MakerPlayground/MakerPlayground_BaseBoard/README.md

# MakerPlayground_BaseBoard
Maker Playground Base Board schematic and PCB design.

Complete the design with Kicad 5.0.2 or newer.
