MakerPlayground/MakerPlayground_BaseBoard/MP_AvrBaseBoard_v4/MakerPlayground_Baseboard.kicad_pcb

## KiCad design MP_AvrBaseBoard_v4/MakerPlayground_Baseboard.kicad_pcb (2021-03-02)

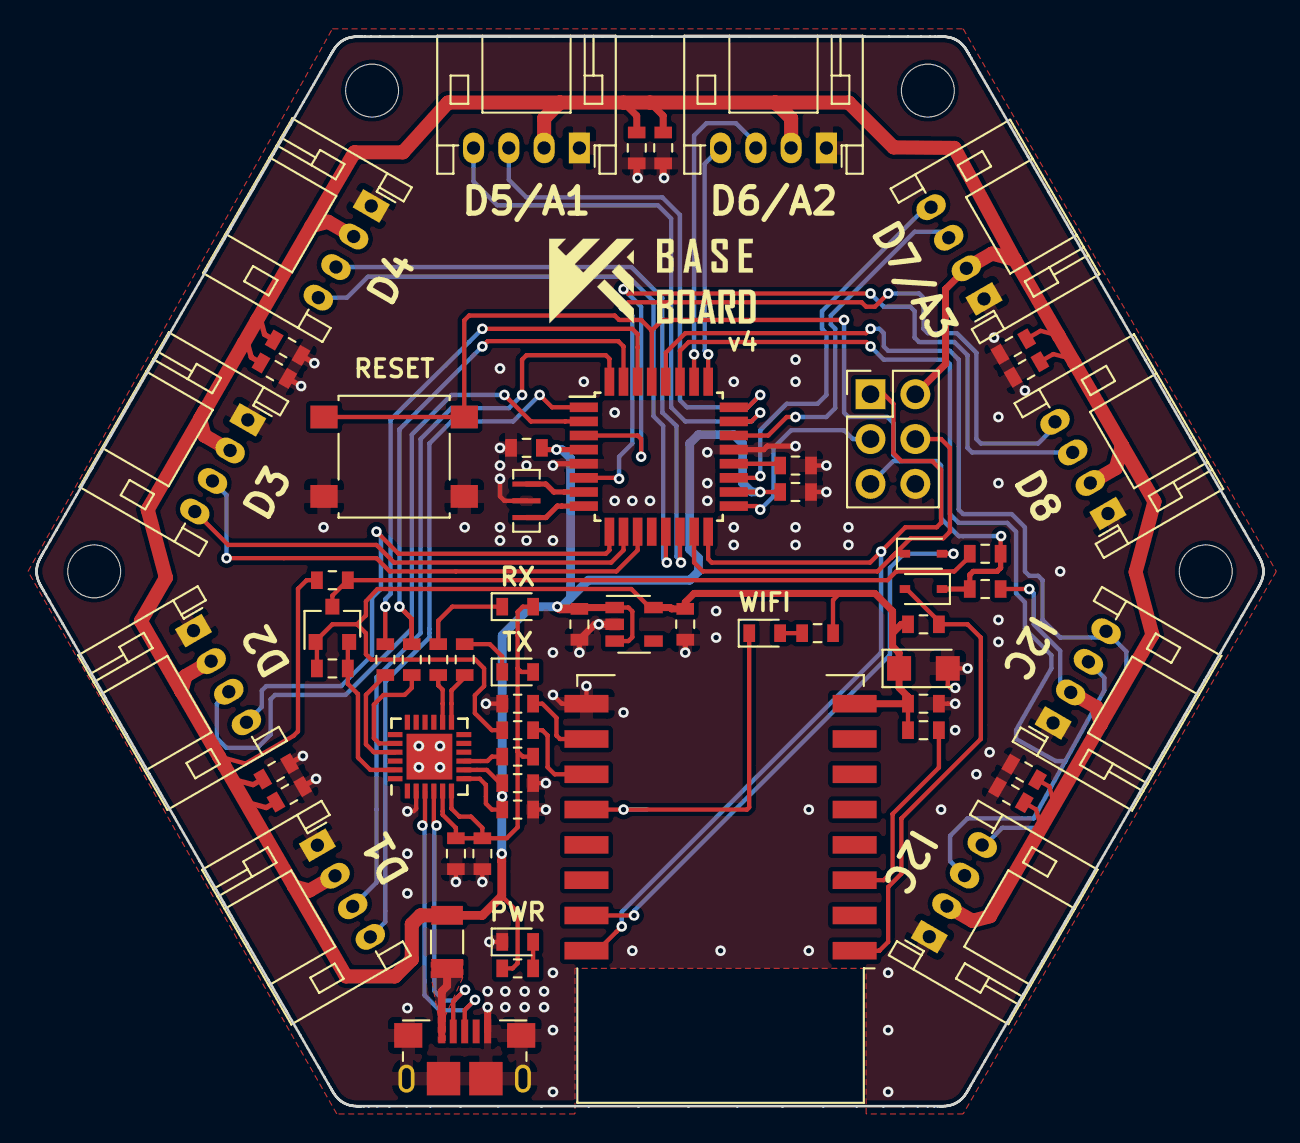
[picture p1: board MakerPlayground_Baseboard.kicad_pcb from above]

Board: 2 copper layers, 69.5 x 60.6 mm, 63 parts (1 on the bottom side), 51 nets.

Parts:
C1, C2: 4.7uF; C_0603_1608Metric
C3, C5, C7, C11, C12, C13, C15, C16, C18, C20, C22: 0.1uF; C_0603_1608Metric
C4, C9, C17, C19, C21: 10uF; C_0603_1608Metric
C6, C8, C14: 1uF; C_0603_1608Metric
C10: 10uF; CP_EIA-3216-12_Kemet-S
D2: Green; LED_0603_1608Metric
D3, D4: Yellow; LED_0603_1608Metric
D5, D7: 1SS355VMTE-17; D_SOD-323
D6: RED; LED_0603_1608Metric
F1: 6V/0.5A; Fuse_1206_3216Metric
J2: USB_B_Micro; USB_Micro-B_Amphenol_10118193_Horizontal
J3: AVR-ISP-6; PinHeader_2x03_P2.54mm_Vertical
J4, J5, J6, J7, J8, J9, J10, J11, J13, J14: 112504RT/RH; JST_PH_S4B-PH-K_1x04_P2.00mm_Horizontal
JP1: Flashing Mode; SolderJumper-2_P1.3mm_Open_Pad1.0x1.5mm
Q2: BSS138; SOT-23
R2, R5, R6, R7, R8, R9, R14: 1K; R_0603_1608Metric
R3, R4, R10, R11, R12, R13, R15: 10K; R_0603_1608Metric
SW1: RESET; SW_SPST_B3S-1000
U2: AP2127K-3.3; SOT-23-5
U3: CP2102N-A01-GQFN24; QFN-24-1EP_4x4mm_P0.5mm_EP2.6x2.6mm
U4: ATmega328PB-MU; TQFP-32_7x7mm_P0.8mm
U5: ESP-12E; ESP-12E_ButtLess
Y1: CSTCE16M0V53-R0; Resonator_Murata_CSTCE-V-3Pin_3.2x1.3mm

Connections:
+3V3: C8.1, C10.1, C14.1, Q2.1, R3.1, R10.2, R11.1, R13.1, R14.1, U2.5, U5.8
+5V: C2.1, C4.1, C5.1, C6.1, C7.1, C9.1, C11.1, C13.1, C16.1, C17.1, C18.1, C19.1, C20.1, C21.1, C22.1, F1.1, J3.2, J4.2, J5.2, J6.2, J7.2, J8.2, J9.2, J10.2, J11.2, J13.2, J14.2, R4.1, R5.1, R15.1, U2.1, U2.3, U3.7, U3.8, U4.4, U4.18
/D+: J2.3, U3.3
/D-: J2.2, U3.4
A0: J5.4, U4.23
A1: J5.3, U4.24
A2: J8.4, U4.25
A3: J8.3, U4.26
A4: J11.4, U4.19
A5: J11.3, U4.22
D2: J4.3, U4.32
D3: J4.4, U4.1
D4: J7.3, U4.2
D5: J7.4, U4.9
D6: J10.4, U4.10
D7: J10.3, U4.11
D9: J13.4, U4.13
D10: J13.3, U4.14
D11: J14.3, U4.3
D12: J14.4, U4.6
DTR: C15.1, Q2.3, R4.2
DTR_3V3: Q2.2, R3.2, U3.23
ESP_RX: D7.1, J3.4, U4.15
ESP_TX: J3.1, U4.16, U5.22
GND: C1.2, C2.2, C3.2, C4.2, C5.2, C6.2, C7.2, C8.2, C9.2, C10.2, C11.2, C12.2, C13.2, C14.2, C16.2, C17.2, C18.2, C19.2, C20.2, C21.2, C22.2, D2.1, J2.5, J2.6, J3.6, J4.1, J5.1, J6.1, J7.1, J8.1, J9.1, J10.1, J11.1, J13.1, J14.1, JP1.2, R12.1, SW1.2, U2.2, U3.2, U3.25, U4.5, U4.21, U5.15, Y1.2
MCU_RX: R7.1, U4.30
MCU_TX: R6.1, U4.31
unnamed: C1.1, C3.1, D3.2, D4.2, R2.1, U3.5, U3.6
unnamed: C12.1, U4.20
unnamed: D2.2, R5.2
unnamed: D3.1, R8.1
unnamed: D4.1, R9.1
unnamed: D5.2, R11.2, U5.1
unnamed: D6.1, JP1.1, U5.18
unnamed: D6.2, R14.2
unnamed: D7.2, U5.21
unnamed: F1.2, J2.1
unnamed: R2.2, U3.9
unnamed: R6.2, U3.20
unnamed: R7.2, U3.21
unnamed: R8.2, U3.13
unnamed: R9.2, U3.14
unnamed: R10.1, U5.3
unnamed: R12.2, U5.16
unnamed: R13.2, U5.17
unnamed: U4.7, Y1.3
unnamed: U4.8, Y1.1
RST: C15.2, D5.1, J3.5, R15.2, SW1.1, U4.29
SCK: J3.3, U4.17
SCL0: J6.4, J9.4, U4.28
SDA0: J6.3, J9.3, U4.27
