MakerPlayground/MakerPlayground_BaseBoard/MP_SamBaseBoard_V1/MP_SamBaseBoard_V1.kicad_pcb

## KiCad design MP_SamBaseBoard_V1/MP_SamBaseBoard_V1.kicad_pcb (2020-07-10)

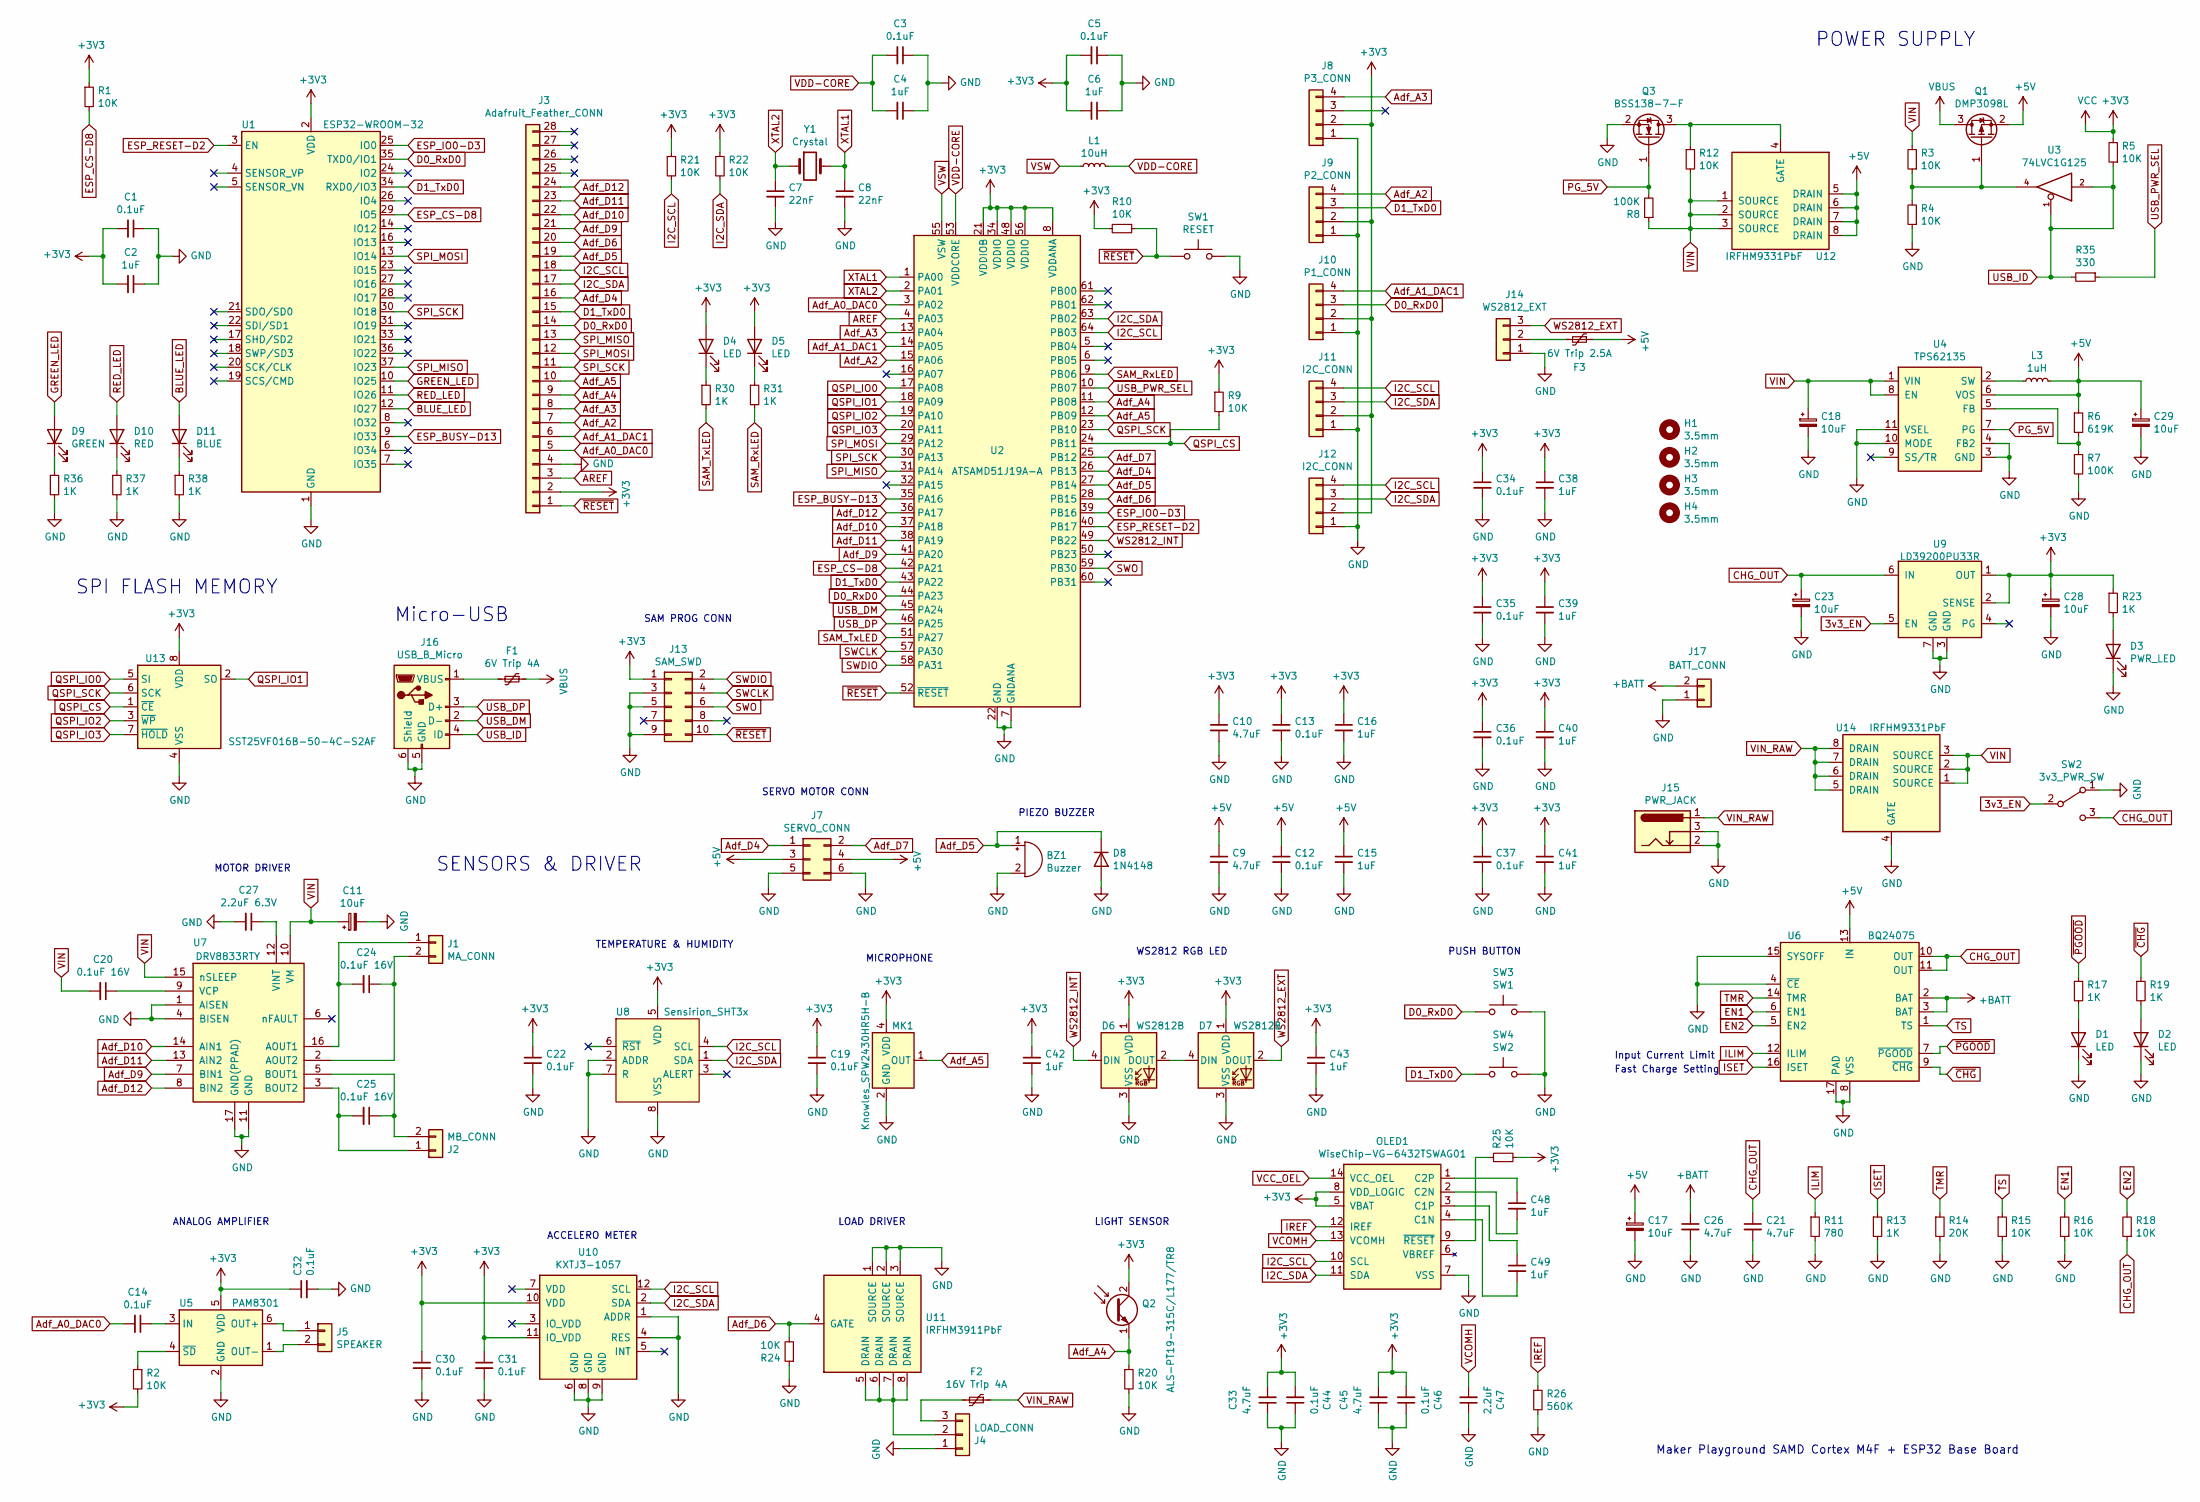
[picture p2: schematic MP_SamBaseBoard_V1.sch]

Parts:
BZ1: Buzzer; MagneticBuzzer_Kobitone_254-EMB84Q-RO
C1, C3, C5, C12, C13, C14, C19, C22, C30, C31, C32, C34, C35, C36, C37, C44, C46: 0.1uF; C_0603_1608Metric
C2, C4, C6, C15, C16, C38, C39, C40, C41, C42, C43, C48, C49: 1uF; C_0603_1608Metric
C7, C8: 22nF; C_0603_1608Metric; Mfg. Part 06036C223KAT2A
C9, C10, C21, C26, C33, C45: 4.7uF; C_0603_1608Metric
C11, C17, C18, C23, C28, C29: 10uF; CP_EIA-3216-12_Kemet-S
C20, C24, C25: 0.1uF 16V; C_0603_1608Metric
C27: 2.2uF 6.3V; C_0603_1608Metric
C47: 2.2uF; C_0603_1608Metric
D1, D2, D4, D5: LED; LED_0603_1608Metric
D3: PWR_LED; LED_0603_1608Metric
D6, D7: WS2812B; WS2812B_MINI
D8: 1N4148; D_SOD-323
D9: GREEN; LED_0603_1608Metric
D10: RED; LED_0603_1608Metric
D11: BLUE; LED_0603_1608Metric
F1: 6V Trip 4A; Fuse_1206_3216Metric; Mfg Part TLC-NSMD200
F2: 16V Trip 4A; Fuse_1812_4532Metric; Mfg Part SMD1812P200TF16
F3: 6V Trip 2.5A; Fuse_1812_4532Metric; Mfg Part MF-MSMF125-2
H1, H2, H3, H4: 3.5mm; MountingHole_3.5mm
J1: MA_CONN; TerminalBlock_Dinkle_ED350V_1x02_P3.50mm_Horizontal
J2: MB_CONN; TerminalBlock_Dinkle_ED350V_1x02_P3.50mm_Horizontal
J3: Adafruit_Feather_CONN; Adafruit-Feather_WoMountPoint_TypeB
J4: LOAD_CONN; TerminalBlock_Dinkle_ED350V_1x03_P3.50mm_Horizontal
J5: SPEAKER; TerminalBlock_Dinkle_ED350V_1x02_P3.50mm_Horizontal
J7: SERVO_CONN; PinHeader_2x03_P2.54mm_Vertical
J8: P3_CONN; JST_PH_B4B-PH-K_1x04_P2.00mm_Vertical
J9: P2_CONN; JST_PH_B4B-PH-K_1x04_P2.00mm_Vertical
J10: P1_CONN; JST_PH_B4B-PH-K_1x04_P2.00mm_Vertical
J11, J12: I2C_CONN; JST_PH_B4B-PH-K_1x04_P2.00mm_Vertical
J13: SAM_SWD; PinHeader_2x05_P1.27mm_Vertical
J14: WS2812_EXT; PinHeader_1x03_P2.54mm_Vertical
J15: PWR_JACK; BarrelJack_Horizontal; Mfg. Part PJ-002A; Mouser No. 490-PJ-002A
J16: USB_B_Micro; USB_Micro-B_Amphenol_10118193_Horizontal
J17: BATT_CONN; TerminalBlock_Dinkle_ED350V_1x02_P3.50mm_Horizontal
L1: 10uH; L_0805_2012Metric; Mfg. Part LQM21DH100M70L
L3: 1uH; SPM6530T; Mfg. Part SPM6530T-1R0M120
MK1: Knowles_SPW2430HR5H-B; SPW2430HR5H-B
OLED1: WiseChip-VG-6432TSWAG01
Q1: DMP3098L; SOT-23
Q2: ALS-PT19-315C/L177/TR8; D_0603_1608Metric
Q3: BSS138-7-F; SOT-23
R1, R2, R3, R4, R5, R9, R10, R12, R15, R16, R18, R20, R21, R22, R24, R25: 10K; R_0603_1608Metric
R6: 619K; R_0603_1608Metric
R7, R8: 100K; R_0603_1608Metric
R11: 780; R_0603_1608Metric
R13, R17, R19, R23, R30, R31, R36, R37, R38: 1K; R_0603_1608Metric
R14: 20K; R_0603_1608Metric
R26: 560K; R_0603_1608Metric
R35: 330; R_0603_1608Metric
SW1: RESET; SW_Push_TS-1145A-B-A
SW2: 3v3_PWR_SW; SSSS811101
SW3: SW1; SW_Push_TS-1145A-B-A
SW4: SW2; SW_Push_TS-1145A-B-A
U1: ESP32-WROOM-32; ESP32-WROOM-32_WifiNinaPin
U2: ATSAMD51J19A-A; TQFP-64_10x10mm_P0.5mm
U3: 74LVC1G125; SOT-23-5
U4: TPS62135; VQFN-HR-11
U5: PAM8301; SOT-23-6
U6: BQ24075; VQFN-16-1EP_3x3mm_P0.5mm_EP1.6x1.6mm_ThermalVias
U7: DRV8833RTY; Texas_S-PWQFN-N16_EP2.1x2.1mm_ThermalVias
U8: Sensirion_SHT3x
U9: LD39200PU33R; DFN-6-1EP_3x3mm_P0.95mm_EP1.7x2.6mm
U10: KXTJ3-1057; LGA-12_2x2mm_P0.5mm
U11: IRFHM3911PbF; PQFN_3x3mm_IRFHM3911PbF
U12, U14: IRFHM9331PbF; PQFN_3x3mm_IRFHM9331TRPbF
U13: SST25VF016B-50-4C-S2AF; SOIC-8_5.275x5.275mm_P1.27mm
Y1: Crystal; Crystal_SMD_2012-2Pin_2.0x1.2mm; Mfg. Part ABS06-127-32.768kHz-T

Connections:
3v3_EN: SW2.2 (B), U9.5 (EN)
+3V3: C1.2, C2.2, C5.2, C6.2, C10.1, C13.1, C16.1, C19.1, C22.1, C28.1, C30.1, C31.1, C32.1, C33.2, C34.1, C35.1, C36.1, C37.1, C38.1, C39.1, C40.1, C41.1, C42.1, C43.1, C44.2, C45.2, C46.2, D4.2 (A), D5.2 (A), D6.1 (VDD), D7.1 (VDD), J3.2, J8.2, J9.2, J10.2, J11.2, J12.2, J13.1, MK1.4 (VDD), OLED1.5 (VBAT), OLED1.8 (VDD_LOGIC), Q2.2 (C), R1.1, R2.2, R5.2, R9.1, R10.2, R21.1, R22.1, R23.1, R25.2, U1.2 (VDD), U2.8 (VDDANA), U2.21 (VDDIOB), U2.34 (VDDIO), U2.48 (VDDIO), U2.56 (VDDIO), U3.5 (VCC), U5.5 (VDD), U8.5 (VDD), U9.1 (OUT), U9.2 (SENSE), U10.10 (VDD), U10.11 (IO_VDD), U13.8 (VDD)
+5V: C9.1, C12.1, C15.1, C17.1, C29.1, F3.1, J7.3, J7.4, L3.2, Q1.2 (S), R6.1, U4.6 (VOS), U6.13 (IN), U12.5 (DRAIN), U12.6 (DRAIN), U12.7 (DRAIN), U12.8 (DRAIN)
+BATT: C26.1, J17.2, U6.2 (BAT), U6.3 (BAT)
AREF: J3.3, U2.4 (PA03)
Adf_A0_DAC0: C14.2, J3.5, U2.3 (PA02)
Adf_A1_DAC1: J3.6, J10.4, U2.14 (PA05)
Adf_A2: J3.7, J9.4, U2.15 (PA06)
Adf_A3: J3.8, J8.4, U2.13 (PA04)
Adf_A4: J3.9, Q2.1 (E), R20.1, U2.11 (PB08)
Adf_A5: J3.10, MK1.1 (OUT), U2.12 (PB09)
Adf_D4: J3.16, J7.1, U2.26 (PB13)
Adf_D5: BZ1.1 (-), D8.1 (K), J3.19, U2.27 (PB14)
Adf_D6: J3.20, R24.2, U2.28 (PB15), U11.4 (GATE)
Adf_D7: J7.2, U2.25 (PB12)
Adf_D9: J3.21, U2.41 (PA20), U7.7 (BIN1)
Adf_D10: J3.22, U2.37 (PA18), U7.14 (AIN1)
Adf_D11: J3.23, U2.38 (PA19), U7.13 (AIN2)
Adf_D12: J3.24, U2.36 (PA17), U7.8 (BIN2)
BLUE_LED: D11.2 (A), U1.12 (IO27)
CHG_OUT: C21.1, C23.1, R18.1, SW2.3 (C), U6.10 (OUT), U6.11 (OUT), U9.6 (IN)
D0_RxD0: J3.14, J10.3, SW3.1, U1.35 (TXD0/IO1), U2.44 (PA23)
D1_TxD0: J3.15, J9.3, SW4.1, U1.34 (RXD0/IO3), U2.43 (PA22)
EN1: R16.2, U6.6 (EN1)
EN2: R18.2, U6.5 (EN2)
ESP_BUSY-D13: U1.9 (IO33), U2.35 (PA16)
ESP_CS-D8: R1.2, U1.29 (IO5), U2.42 (PA21)
ESP_IO0-D3: U1.25 (IO0), U2.39 (PB16)
ESP_RESET-D2: U1.3 (EN), U2.40 (PB17)
GND: BZ1.2 (+), C1.1, C2.1, C3.1, C4.1, C5.1, C6.1, C7.2, C8.2, C9.2, C10.2, C11.2, C12.2, C13.2, C15.2, C16.2, C17.2, C18.2, C19.2, C21.2, C22.2, C23.2, C26.2, C27.2, C28.2, C29.2, C30.2, C31.2, C32.2, C33.1, C34.2, C35.2, C36.2, C37.2, C38.2, C39.2, C40.2, C41.2, C42.2, C43.2, C44.1, C45.1, C46.1, C47.1, D1.1 (K), D2.1 (K), D3.1 (K), D6.3 (VSS), D7.3 (VSS), D8.2 (A), J3.4, J4.1, J7.5, J7.6, J8.1, J9.1, J10.1, J11.1, J12.1, J13.3, J13.5, J13.9, J14.1, J15.2, J15.3, J16.5 (GND), J16.6 (Shield), J17.1, MK1.2 (GND), MK1.3 (GND), OLED1.7 (VSS), Q3.2 (S), R4.1, R7.2, R11.2, R13.2, R14.2, R15.2, R16.1, R20.2, R24.1, R26.2, R36.2, R37.2, R38.2, SW1.2, SW2.1 (A), SW3.2, SW4.2, U1.1 (GND), U1.15 (GND), U1.38 (GND), U1.39 (GND), U2.7 (GNDANA), U2.22 (GND), U2.33 (GND), U2.47 (GND), U2.54 (GND), U3.3 (GND), U4.3 (GND), U4.4 (FB2), U4.10 (MODE), U4.11 (VSEL), U5.2 (GND), U6.4 (~CE), U6.8 (VSS), U6.15 (SYSOFF), U6.17 (PAD), U7.1 (AISEN), U7.4 (BISEN), U7.11 (GND), U7.17 (GND(PPAD)), U8.2 (ADDR), U8.7 (R), U8.8 (VSS), U8.9 (PAD), U9.3 (GND), U9.7 (GND), U10.1 (ADDR), U10.4 (RES), U10.6 (GND), U10.8 (GND), U10.9 (GND), U11.1 (SOURCE), U11.2 (SOURCE), U11.3 (SOURCE), U13.4 (VSS), U14.4 (GATE)
GREEN_LED: D9.2 (A), U1.10 (IO25)
I2C_SCL: J3.18, J11.4, J12.4, OLED1.10 (SCL), R21.2, U2.64 (PB03), U8.4 (SCL), U10.12 (SCL)
I2C_SDA: J3.17, J11.3, J12.3, OLED1.11 (SDA), R22.2, U2.63 (PB02), U8.1 (SDA), U10.2 (SDA)
ILIM: R11.1, U6.12 (ILIM)
IREF: OLED1.12 (IREF), R26.1
ISET: R13.1, U6.16 (ISET)
unnamed: C14.1, U5.3 (IN)
unnamed: C20.1, U7.9 (VCP)
unnamed: C24.1, J1.2, U7.2 (AOUT2)
unnamed: C24.2, J1.1, U7.16 (AOUT1)
unnamed: C25.1, J2.2, U7.5 (BOUT1)
unnamed: C25.2, J2.1, U7.3 (BOUT2)
unnamed: C27.1, U7.12 (VINT)
unnamed: C48.1, OLED1.1 (C2P)
unnamed: C48.2, OLED1.2 (C2N)
unnamed: C49.1, OLED1.3 (C1P)
unnamed: C49.2, OLED1.4 (C1N)
unnamed: D1.2 (A), R17.2
unnamed: D2.2 (A), R19.2
unnamed: D3.2 (A), R23.2
unnamed: D4.1 (K), R30.1
unnamed: D5.1 (K), R31.1
unnamed: D6.2 (DOUT), D7.4 (DIN)
unnamed: D9.1 (K), R36.1
unnamed: D10.1 (K), R37.1
unnamed: D11.1 (K), R38.1
unnamed: F1.2, J16.1 (VBUS)
unnamed: F2.2, J4.3
unnamed: F3.2, J14.2
unnamed: J4.2, U11.5 (DRAIN), U11.6 (DRAIN), U11.7 (DRAIN), U11.8 (DRAIN)
unnamed: J5.1, U5.6 (OUT+)
unnamed: J5.2, U5.1 (OUT-)
unnamed: L3.1, U4.2 (SW)
unnamed: OLED1.9 (~RESET), R25.1
unnamed: Q1.1 (G), R3.1, R4.2, U3.4
unnamed: Q3.3 (D), R12.1, U12.4 (GATE)
unnamed: R2.1, U5.4 (~SD)
unnamed: R6.2, R7.1, U4.5 (FB)
PG_5V: Q3.1 (G), R8.2, U4.7 (PG)
QSPI_CS: R9.2, U2.24 (PB11), U13.1 (~CE)
QSPI_IO0: U2.17 (PA08), U13.5 (SI)
QSPI_IO1: U2.18 (PA09), U13.2 (SO)
QSPI_IO2: U2.19 (PA10), U13.3 (~WP~)
QSPI_IO3: U2.20 (PA11), U13.7 (~HOLD~)
QSPI_SCK: U2.23 (PB10), U13.6 (SCK)
RED_LED: D10.2 (A), U1.11 (IO26)
SAM_RxLED: R31.2, U2.9 (PB06)
SAM_TxLED: R30.2, U2.51 (PA27)
SPI_MISO: J3.13, U1.37 (IO23), U2.31 (PA14)
SPI_MOSI: J3.12, U1.13 (IO14), U2.29 (PA12)
SPI_SCK: J3.11, U1.30 (IO18), U2.30 (PA13)
SWCLK: J13.4, U2.57 (PA30)
SWDIO: J13.2, U2.58 (PA31)
SWO: J13.6, U2.59 (PB30)
TMR: R14.1, U6.14 (TMR)
TS: R15.1, U6.1 (TS)
USB_DM: J16.2 (D-), U2.45 (PA24)
USB_DP: J16.3 (D+), U2.46 (PA25)
USB_ID: J16.4 (ID), R5.1, R35.2, U3.1, U3.2
USB_PWR_SEL: R35.1, U2.10 (PB07)
VBUS: F1.1, Q1.3 (D)
VCOMH: C47.2, OLED1.13 (VCOMH)
VDD-CORE: C3.2, C4.2, L1.2, U2.53 (VDDCORE)
VIN: C11.1, C18.1, C20.2, R3.2, R8.1, R12.2, U4.1 (VIN), U4.8 (EN), U7.10 (VM), U7.15 (nSLEEP), U12.1 (SOURCE), U12.2 (SOURCE), U12.3 (SOURCE), U14.1 (SOURCE), U14.2 (SOURCE), U14.3 (SOURCE)
VIN_RAW: F2.1, J15.1, U14.5 (DRAIN), U14.6 (DRAIN), U14.7 (DRAIN), U14.8 (DRAIN)
VSW: L1.1, U2.55 (VSW)
WS2812_EXT: D7.2 (DOUT), J14.3
WS2812_INT: D6.4 (DIN), U2.49 (PB22)
XTAL1: C8.1, U2.1 (PA00), Y1.2
XTAL2: C7.1, U2.2 (PA01), Y1.1
~CHG: R19.1, U6.9 (~CHG)
~PGOOD: R17.1, U6.7 (~PGOOD)
~RESET: J3.1, J13.10, R10.1, SW1.1, U2.52 (~RESET)

Notes on the sheet:
POWER SUPPLY
SENSORS & DRIVER
ACCELERO METER
TEMPERATURE & HUMIDITY
MOTOR DRIVER
ANALOG AMPLIFIER
LOAD DRIVER
MICROPHONE
Maker Playground SAMD Cortex M4F + ESP32 Base Board
PIEZO BUZZER
SPI FLASH MEMORY
Fast Charge Setting
Input Current Limit
Micro-USB
SERVO MOTOR CONN
SAM PROG CONN
WS2812 RGB LED
LIGHT SENSOR
PUSH BUTTON

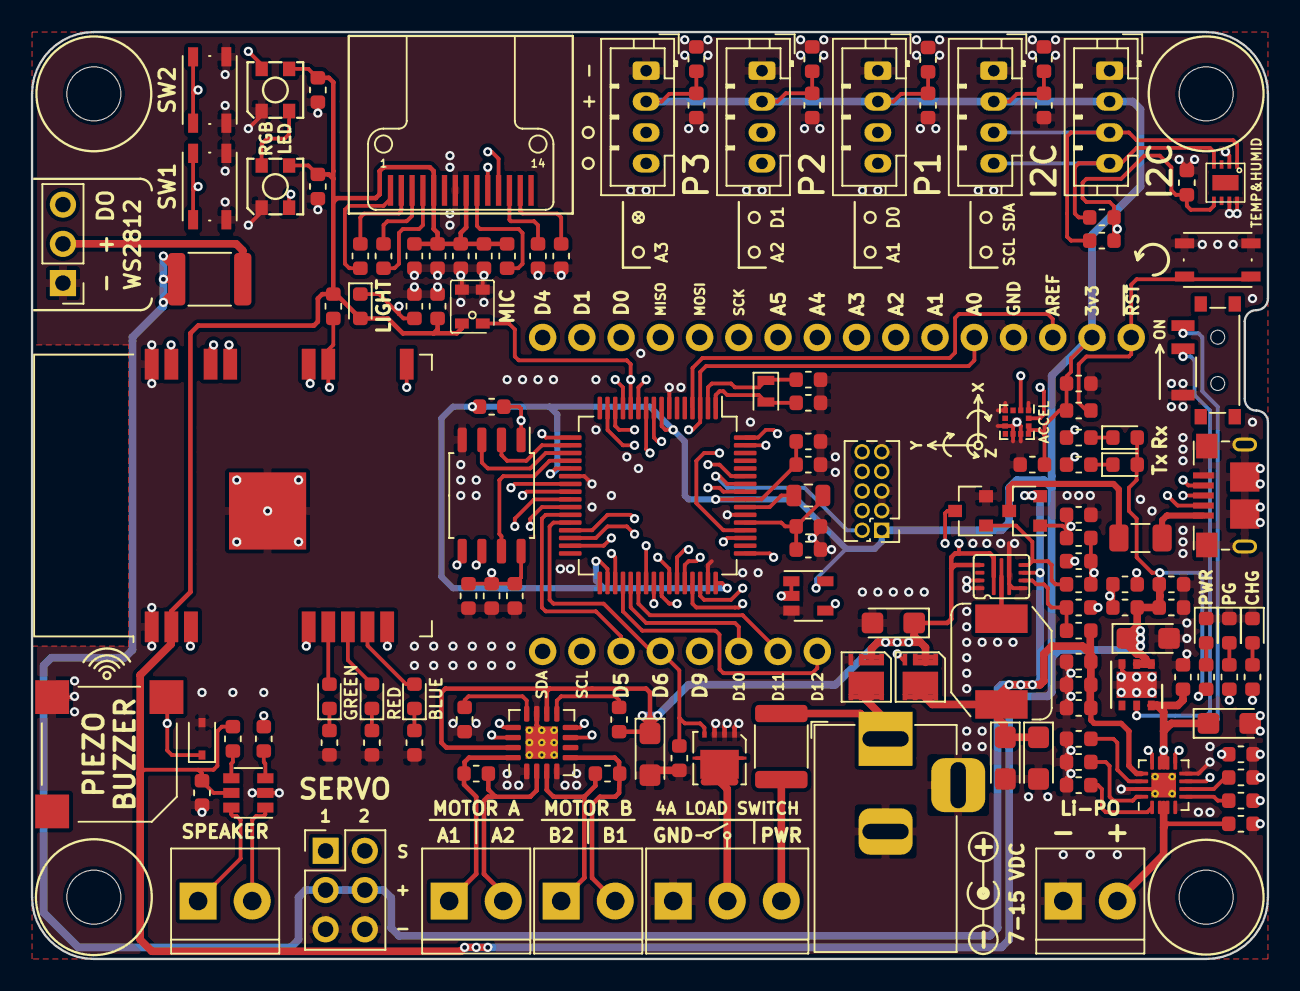
[picture p3: board MP_SamBaseBoard_V1.kicad_pcb from above]

Board: 4 copper layers, 80.0 x 60.0 mm, 142 parts (0 on the bottom side), 103 nets.
