MakerPlayground/MakerPlayground_BaseBoard/MP_TinyBaseBoard_v1/MakerPlayground_TinyBaseBoard.kicad_pcb

## KiCad design MP_TinyBaseBoard_v1/MakerPlayground_TinyBaseBoard.kicad_pcb (2019-02-23)

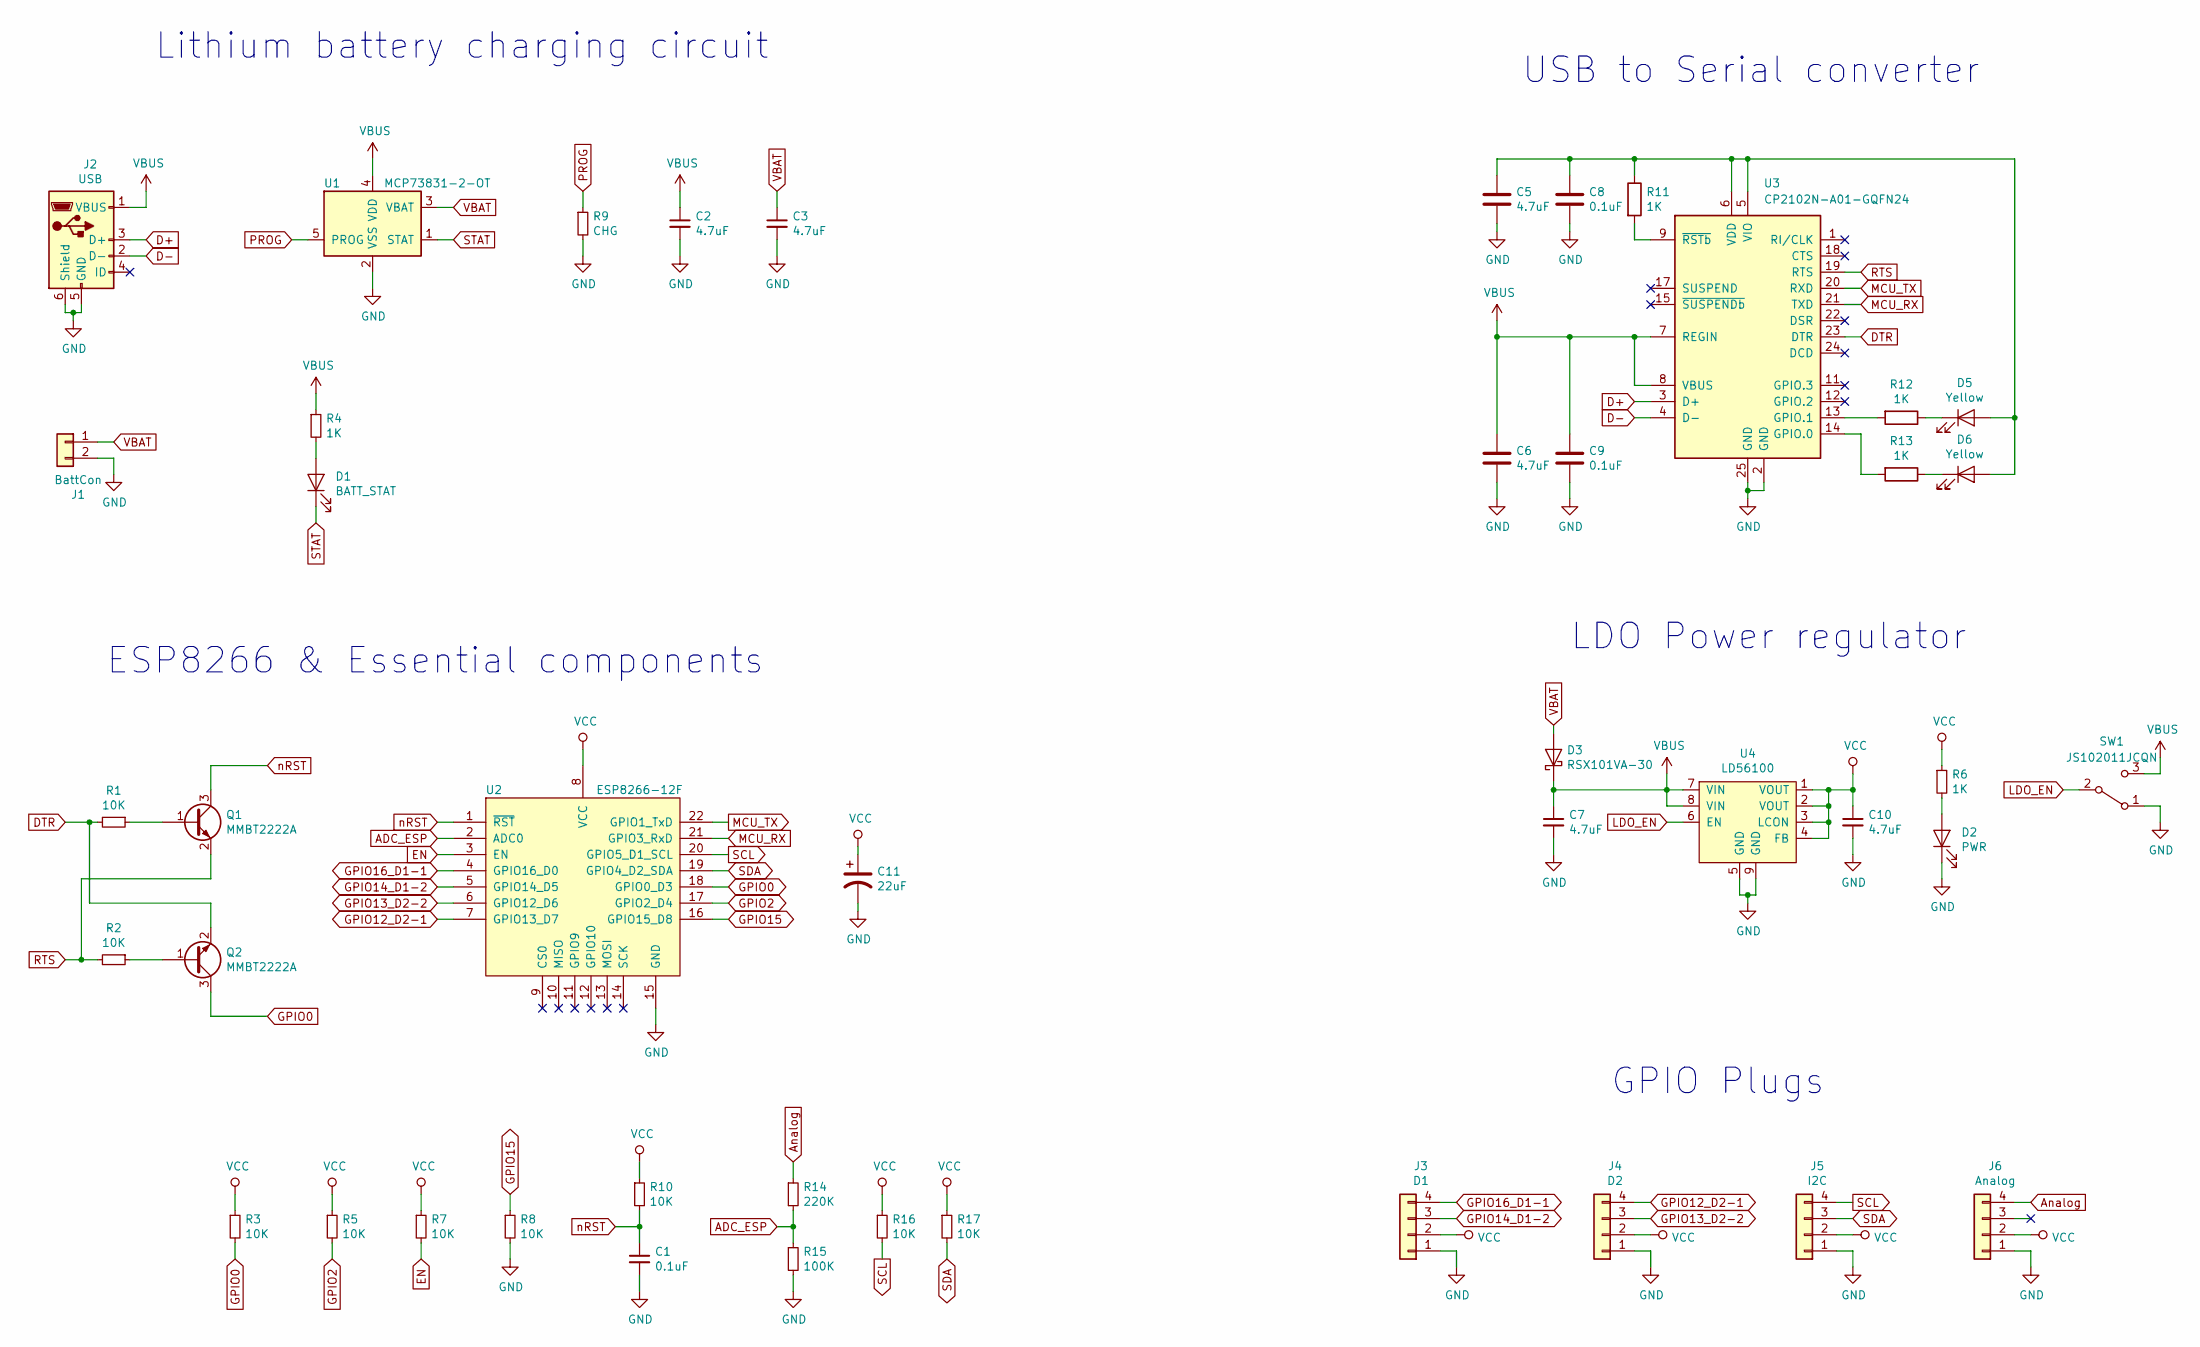
[picture p4: schematic MakerPlayground_TinyBaseBoard.sch]

Parts:
C1, C8, C9: 0.1uF; C_0603_1608Metric
C2, C3, C5, C6, C7, C10: 4.7uF; C_0603_1608Metric
C11: 22uF; CP_EIA-3216-10_Kemet-I
D1: BATT_STAT; LED_0603_1608Metric
D2: PWR; LED_0603_1608Metric
D3: RSX101VA-30; D_TUMD2
D5, D6: Yellow; LED_0603_1608Metric
J1: BattCon; PinHeader_1x02_P2.54mm_Vertical
J2: USB; USB_Micro-B_Amphenol_10118193_Horizontal
J3: D1; JST_PH_B4B-PH-K_1x04_P2.00mm_Vertical
J4: D2; JST_PH_B4B-PH-K_1x04_P2.00mm_Vertical
J5: I2C; JST_PH_B4B-PH-K_1x04_P2.00mm_Vertical
J6: Analog; JST_PH_B4B-PH-K_1x04_P2.00mm_Vertical
Q1, Q2: MMBT2222A; SOT-23
R1, R2, R3, R5, R7, R8, R10, R16, R17: 10K; R_0603_1608Metric
R4, R6, R11, R12, R13: 1K; R_0603_1608Metric
R9: CHG; R_0603_1608Metric
R14: 220K; R_0603_1608Metric
R15: 100K; R_0603_1608Metric
SW1: JS102011JCQN; SW_SPDT_CK-JS102011JCQN
U1: MCP73831-2-OT; SOT-23-5
U2: ESP8266-12F; ESP-12E_ButtLess
U3: CP2102N-A01-GQFN24; QFN-24-1EP_4x4mm_P0.5mm_EP2.6x2.6mm
U4: LD56100; ST_DFN-8-1EP_1.6x1.2mm_P0.4mm

Connections:
ADC_ESP: R14.2, R15.1, U2.2 (ADC0)
Analog: J6.4, R14.1
D+: J2.3 (D+), U3.3 (D+)
D-: J2.2 (D-), U3.4 (D-)
DTR: Q2.2 (E), R1.2, U3.23 (DTR)
EN: R7.2, U2.3 (EN)
GND: C1.2, C2.2, C3.2, C5.2, C6.2, C7.2, C8.2, C9.2, C10.2, C11.2, D2.1 (K), J1.2, J2.5 (GND), J2.6 (Shield), J3.1, J4.1, J5.1, J6.1, R8.2, R9.2, R15.2, SW1.1 (A), U1.2 (VSS), U2.15 (GND), U3.2 (GND), U3.25 (GND), U4.5 (GND), U4.9 (GND)
GPIO0: Q2.3 (C), R3.2, U2.18 (GPIO0_D3)
GPIO2: R5.2, U2.17 (GPIO2_D4)
GPIO12_D2-1: J4.4, U2.7 (GPIO13_D7)
GPIO13_D2-2: J4.3, U2.6 (GPIO12_D6)
GPIO14_D1-2: J3.3, U2.5 (GPIO14_D5)
GPIO15: R8.1, U2.16 (GPIO15_D8)
GPIO16_D1-1: J3.4, U2.4 (GPIO16_D0)
LDO_EN: SW1.2 (B), U4.6 (EN)
MCU_RX: U2.21 (GPIO3_RxD), U3.21 (TXD)
MCU_TX: U2.22 (GPIO1_TxD), U3.20 (RXD)
unnamed: C5.1, C8.1, D5.2 (A), D6.2 (A), R11.1, U3.5 (VIO), U3.6 (VDD)
unnamed: D1.2 (A), R4.2
unnamed: D2.2 (A), R6.2
unnamed: D5.1 (K), R12.1
unnamed: D6.1 (K), R13.1
unnamed: Q1.1 (B), R1.1
unnamed: Q2.1 (B), R2.1
unnamed: R11.2, U3.9 (~RSTb)
unnamed: R12.2, U3.13 (GPIO.1)
unnamed: R13.2, U3.14 (GPIO.0)
PROG: R9.1, U1.5 (PROG)
RTS: Q1.2 (E), R2.2, U3.19 (RTS)
SCL: J5.4, R16.2, U2.20 (GPIO5_D1_SCL)
SDA: J5.3, R17.2, U2.19 (GPIO4_D2_SDA)
STAT: D1.1 (K), U1.1 (STAT)
VBAT: C3.1, D3.2 (A), J1.1, U1.3 (VBAT)
VBUS: C2.1, C6.1, C7.1, C9.1, D3.1 (K), J2.1 (VBUS), R4.1, SW1.3 (C), U1.4 (VDD), U3.7 (REGIN), U3.8 (VBUS), U4.7 (VIN), U4.8 (VIN)
VCC: C10.1, C11.1, J3.2, J4.2, J5.2, J6.2, R3.1, R5.1, R6.1, R7.1, R10.1, R16.1, R17.1, U2.8 (VCC), U4.1 (VOUT), U4.2 (VOUT), U4.3 (LCON), U4.4 (FB)
nRST: C1.1, Q1.3 (C), R10.2, U2.1 (~RST)

Notes on the sheet:
Lithium battery charging circuit
USB to Serial converter
LDO Power regulator
ESP8266 & Essential components
GPIO Plugs

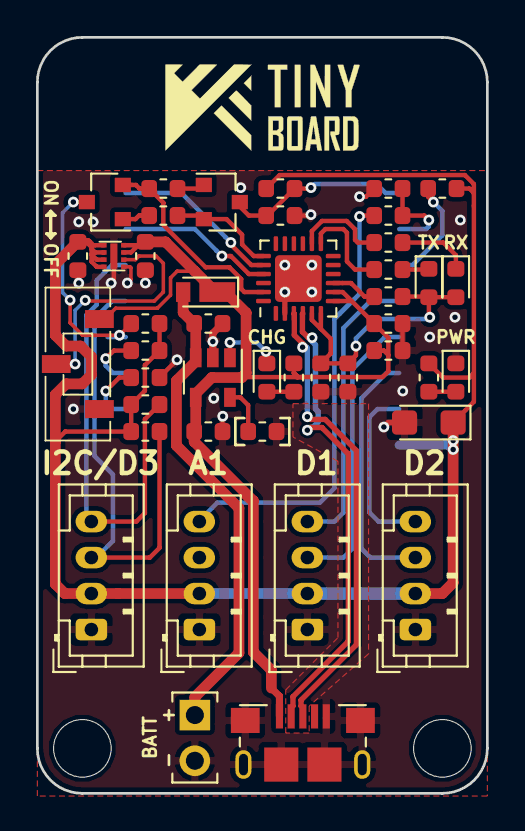
[picture p5: board MakerPlayground_TinyBaseBoard.kicad_pcb from above]

Board: 2 copper layers, 25.0 x 42.0 mm, 45 parts (1 on the bottom side), 36 nets.
