MakerPlayground/MakerPlayground_BaseBoard/MP_MegaBaseBoard_v1/MakerPlayground_MegaBaseBoard.kicad_pcb

## KiCad design MP_MegaBaseBoard_v1/MakerPlayground_MegaBaseBoard.kicad_pcb (2019-02-23)

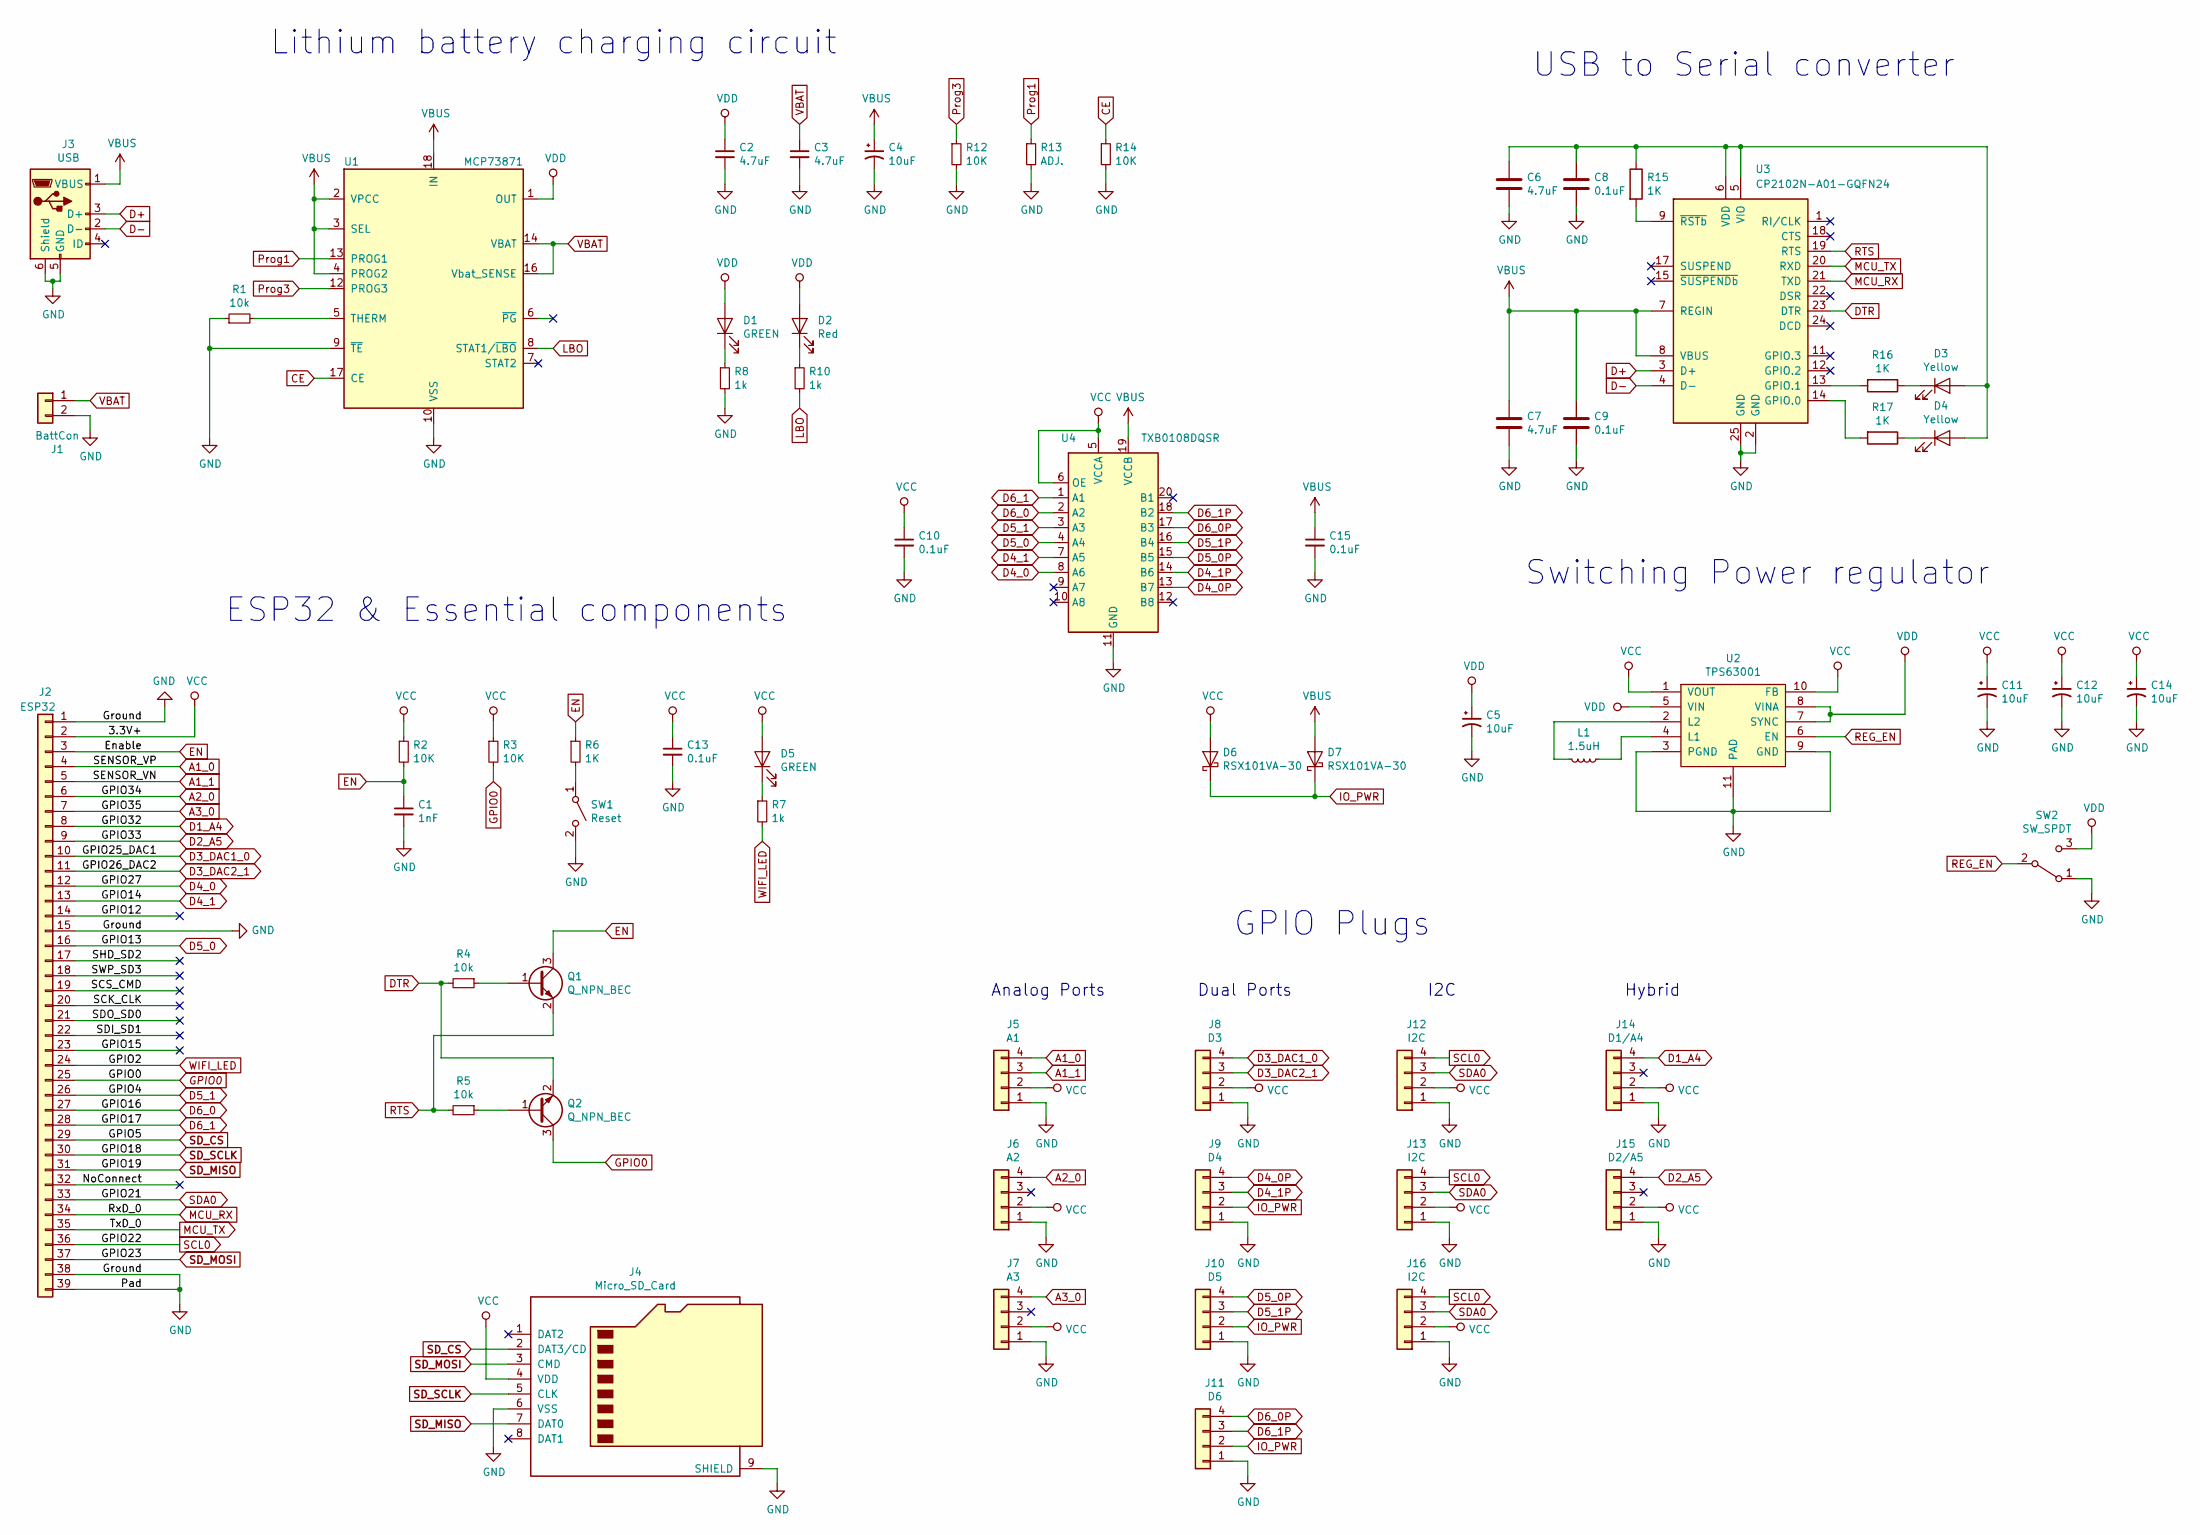
[picture p6: schematic MakerPlayground_MegaBaseBoard.sch]

Parts:
C1: 1nF; C_0603_1608Metric
C2, C3, C6, C7: 4.7uF; C_0603_1608Metric
C4, C5, C11, C12, C14: 10uF; C_0805_2012Metric
C8, C9, C10, C13, C15: 0.1uF; C_0603_1608Metric
D1, D5: GREEN; LED_0603_1608Metric
D2: Red; LED_0603_1608Metric
D3, D4: Yellow; LED_0603_1608Metric
D6, D7: RSX101VA-30; D_TUMD2
J1: BattCon; JST_PH_S2B-PH-K_1x02_P2.00mm_Horizontal
J2: ESP32; ESP32-WROOM-32
J3: USB; USB_Micro-B_Amphenol_10118193_Horizontal
J4: Micro_SD_Card; GTK_TFMS08TK-PP-02; Mfg Part No. TFMS08TK-PP-02
J5: A1; JST_PH_B4B-PH-K_1x04_P2.00mm_Vertical
J6: A2; JST_PH_B4B-PH-K_1x04_P2.00mm_Vertical
J7: A3; JST_PH_B4B-PH-K_1x04_P2.00mm_Vertical
J8: D3; JST_PH_B4B-PH-K_1x04_P2.00mm_Vertical
J9: D4; JST_PH_B4B-PH-K_1x04_P2.00mm_Vertical
J10: D5; JST_PH_B4B-PH-K_1x04_P2.00mm_Vertical
J11: D6; JST_PH_B4B-PH-K_1x04_P2.00mm_Vertical
J12, J13, J16: I2C; JST_PH_B4B-PH-K_1x04_P2.00mm_Vertical
J14: D1/A4; JST_PH_B4B-PH-K_1x04_P2.00mm_Vertical
J15: D2/A5; JST_PH_B4B-PH-K_1x04_P2.00mm_Vertical
L1: 1.5uH; L_1008(2520); Mouser Part No. 81-DFE201610P-2R2MP2
Q1, Q2: Q_NPN_BEC; SOT-23
R1, R4, R5: 10k; R_0603_1608Metric
R2, R3, R12, R14: 10K; R_0603_1608Metric
R6, R15, R16, R17: 1K; R_0603_1608Metric
R7, R8, R10: 1k; R_0603_1608Metric
R13: ADJ.; R_0603_1608Metric
SW1: Reset; TTS-35-C-1-P
SW2: SW_SPDT; SW_SPDT_CK-JS102011JCQN
U1: MCP73871; QFN-20-1EP_4x4mm_P0.5mm_EP2.5x2.5mm
U2: TPS63001; VSON-10-1EP_3x3mm_P0.5mm_EP1.65x2.4mm_ThermalVias
U3: CP2102N-A01-GQFN24; QFN-24-1EP_4x4mm_P0.5mm_EP2.6x2.6mm
U4: TXB0108DQSR; USON-20_2x4mm_P0.4mm

Connections:
/GPIO12: J2.14
/GPIO15: J2.23
/NoConnect: J2.32
/SCK_CLK: J2.20
/SCS_CMD: J2.19
/SDI_SD1: J2.22
/SDO_SD0: J2.21
/SHD_SD2: J2.17
/SWP_SD3: J2.18
A1_0: J2.4, J5.4
A1_1: J2.5, J5.3
A2_0: J2.6, J6.4
A3_0: J2.7, J7.4
CE: R14.1, U1.17 (CE)
D1_A4: J2.8, J14.4
D2_A5: J2.9, J15.4
D3_DAC1_0: J2.10, J8.4
D3_DAC2_1: J2.11, J8.3
D4_0: J2.12, U4.8 (A6)
D4_0P: J9.4, U4.13 (B7)
D4_1: J2.13, U4.7 (A5)
D4_1P: J9.3, U4.14 (B6)
D5_0: J2.16, U4.4 (A4)
D5_0P: J10.4, U4.15 (B5)
D5_1: J2.26, U4.3 (A3)
D5_1P: J10.3, U4.16 (B4)
D6_0: J2.27, U4.2 (A2)
D6_0P: J11.4, U4.17 (B3)
D6_1: J2.28, U4.1 (A1)
D6_1P: J11.3, U4.18 (B2)
D+: J3.3 (D+), U3.3 (D+)
D-: J3.2 (D-), U3.4 (D-)
DTR: Q2.2 (E), R4.2, U3.23 (DTR)
EN: C1.1, J2.3, Q1.3 (C), R2.2, R6.1
GND: C1.2, C2.2, C3.2, C4.2, C5.2, C6.2, C7.2, C8.2, C9.2, C10.2, C11.2, C12.2, C13.2, C14.2, C15.2, J1.2, J2.1, J2.15, J2.38, J2.39, J3.5 (GND), J3.6 (Shield), J4.6 (VSS), J4.9 (SHIELD), J5.1, J6.1, J7.1, J8.1, J9.1, J10.1, J11.1, J12.1, J13.1, J14.1, J15.1, J16.1, R1.1, R8.2, R12.2, R13.2, R14.2, SW1.2 (B), SW2.1 (A), U1.9 (~TE), U1.10 (VSS), U1.11 (VSS), U1.21 (VSS), U2.3 (PGND), U2.9 (GND), U2.11 (PAD), U3.2 (GND), U3.25 (GND), U4.11 (GND)
GPIO0: J2.25, Q2.3 (C), R3.2
IO_PWR: D6.1 (K), D7.1 (K), J9.2, J10.2, J11.2
LBO: R10.2, U1.8 (STAT1/~LBO~)
MCU_RX: J2.34, U3.21 (TXD)
MCU_TX: J2.35, U3.20 (RXD)
unnamed: C6.1, C8.1, D3.2 (A), D4.2 (A), R15.1, U3.5 (VIO), U3.6 (VDD)
unnamed: D1.1 (K), R8.1
unnamed: D2.1 (K), R10.1
unnamed: D3.1 (K), R16.1
unnamed: D4.1 (K), R17.1
unnamed: D5.1 (K), R7.1
unnamed: L1.1, U2.4 (L1)
unnamed: L1.2, U2.2 (L2)
unnamed: Q1.1 (B), R4.1
unnamed: Q2.1 (B), R5.1
unnamed: R1.2, U1.5 (THERM)
unnamed: R6.2, SW1.1 (A)
unnamed: R15.2, U3.9 (~RSTb)
unnamed: R16.2, U3.13 (GPIO.1)
unnamed: R17.2, U3.14 (GPIO.0)
Prog1: R13.1, U1.13 (PROG1)
Prog3: R12.1, U1.12 (PROG3)
REG_EN: SW2.2 (B), U2.6 (EN)
RTS: Q1.2 (E), R5.2, U3.19 (RTS)
SCL0: J2.36, J12.4, J13.4, J16.4
SDA0: J2.33, J12.3, J13.3, J16.3
SD_CS: J2.29, J4.2 (DAT3/CD)
SD_MISO: J2.31, J4.7 (DAT0)
SD_MOSI: J2.37, J4.3 (CMD)
SD_SCLK: J2.30, J4.5 (CLK)
VBAT: C3.1, J1.1, U1.14 (VBAT), U1.15 (VBAT), U1.16 (Vbat_SENSE)
VBUS: C4.1, C7.1, C9.1, C15.1, D7.2 (A), J3.1 (VBUS), U1.2 (VPCC), U1.3 (SEL), U1.4 (PROG2), U1.18 (IN), U1.19 (IN), U3.7 (REGIN), U3.8 (VBUS), U4.19 (VCCB)
VCC: C10.1, C11.1, C12.1, C13.1, C14.1, D5.2 (A), D6.2 (A), J2.2, J4.4 (VDD), J5.2, J6.2, J7.2, J8.2, J12.2, J13.2, J14.2, J15.2, J16.2, R2.1, R3.1, U2.1 (VOUT), U2.10 (FB), U4.5 (VCCA), U4.6 (OE)
VDD: C2.1, C5.1, D1.2 (A), D2.2 (A), SW2.3 (C), U1.1 (OUT), U1.20 (OUT), U2.5 (VIN), U2.7 (SYNC), U2.8 (VINA)
WIFI_LED: J2.24, R7.2

Notes on the sheet:
Lithium battery charging circuit
USB to Serial converter
Switching Power regulator
ESP32 & Essential components
GPIO Plugs
Analog Ports
Dual Ports
I2C
Hybrid

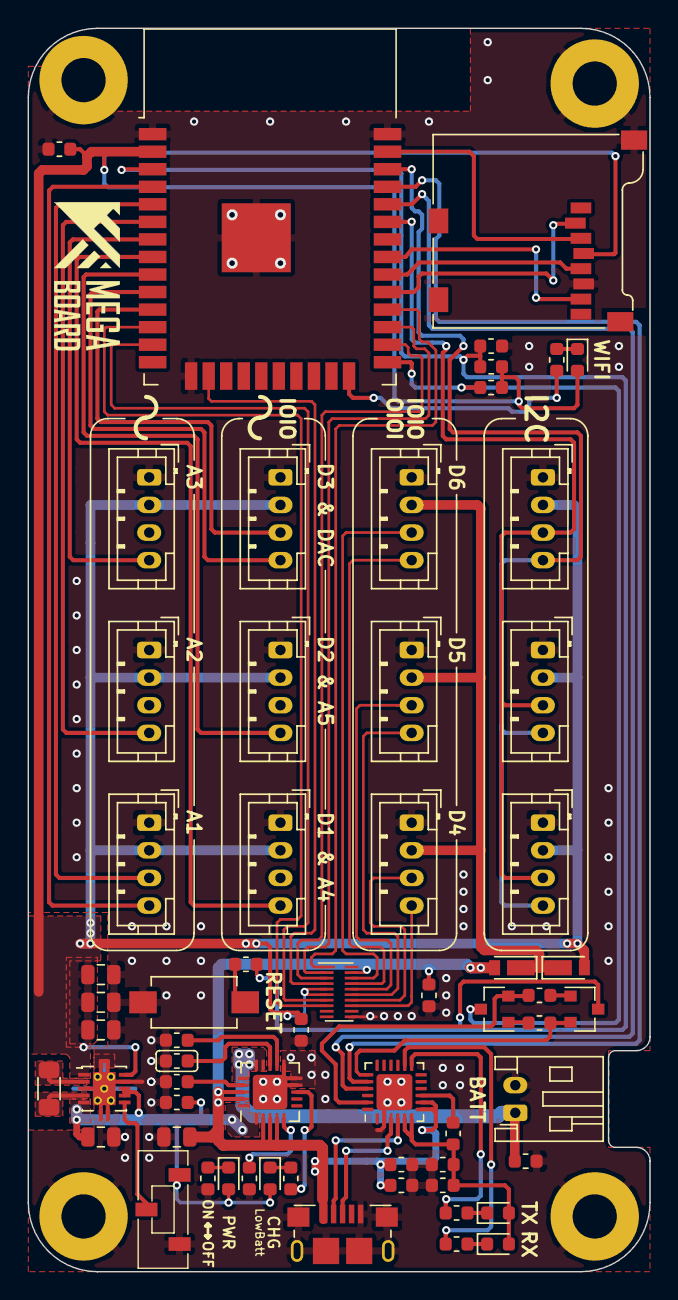
[picture p7: board MakerPlayground_MegaBaseBoard.kicad_pcb from above]

Board: 2 copper layers, 45.0 x 90.0 mm, 62 parts (0 on the bottom side), 61 nets.
