MakerPlayground/MakerPlayground_BaseBoard/(commit log)

2019-02-23 ~ 1st commit ~
    [MakerPlayground_Baseboard.kicad_pcb, MakerPlayground_Baseboard.sch, MakerPlayground_MegaBaseBoard.csv, MakerPlayground_MegaBaseBoard.kicad_pcb, MakerPlayground_MegaBaseBoard.sch, MakerPlayground_TinyBaseBoard.kicad_pcb, MakerPlayground_TinyBaseBoard.sch]
2019-05-28 Fix the GREATEST ERROR on I2C & GND PTH overlap.
    [MakerPlayground_Baseboard.kicad_pcb]
2020-04-20 Add SamBaseBoard_V1
    [MP_SamBaseBoard_V1.kicad_pcb, MP_SamBaseBoard_V1.sch]
2020-04-21 Add new design
    [MP_SamBaseBoard_V1.kicad_pcb]
2020-04-26 Fork new draft design dir
    [MP_SamBaseBoard_V1.kicad_pcb, MP_SamBaseBoard_V1.sch]
2020-04-27 Start schematic design
2020-05-12 update schematic
    [MP_SamBaseBoard_V1.sch]
2020-05-13 Finalize schematic
    [MP_SamBaseBoard_V1.sch]
2020-05-13 Schematic done, update pcb
    [MP_SamBaseBoard_V1.kicad_pcb, MP_SamBaseBoard_V1.sch]
2020-05-14 Progress in PCB, QSPI flash not complete in schematics
    [MP_SamBaseBoard_V1.kicad_pcb, MP_SamBaseBoard_V1.sch]
2020-05-18 update & looking forward to be 4-layer
    [MP_SamBaseBoard_V1.kicad_pcb]
2020-05-19 update to 4-layer
    [MP_SamBaseBoard_V1.kicad_pcb, MP_SamBaseBoard_V1.sch]
2020-05-25 Footprint replacement pending
    [MP_SamBaseBoard_V1.kicad_pcb, MP_SamBaseBoard_V1.sch]
2020-05-26 Finalize to V0.1 demo version
    [MP_SamBaseBoard_V1-B_Cu.gbr, MP_SamBaseBoard_V1-B_Mask.gbr, MP_SamBaseBoard_V1-B_Paste.gbr, MP_SamBaseBoard_V1-B_SilkS.gbr, MP_SamBaseBoard_V1-Edge_Cuts.gbr, MP_SamBaseBoard_V1-F_Cu.gbr, MP_SamBaseBoard_V1-F_Mask.gbr, MP_SamBaseBoard_V1-F_Paste.gbr]
2020-05-26 Add plot & drill files
2020-05-27 Add BOM file
    [MP_SamBaseBoard_V1.csv]
2020-05-27 update BOM file
2020-06-03 Fix pull resistor
    [MP_SamBaseBoard_V1-B_Cu.gbr, MP_SamBaseBoard_V1-B_Mask.gbr, MP_SamBaseBoard_V1-B_Paste.gbr, MP_SamBaseBoard_V1-B_SilkS.gbr, MP_SamBaseBoard_V1-Edge_Cuts.gbr, MP_SamBaseBoard_V1-F_Cu.gbr, MP_SamBaseBoard_V1-F_Mask.gbr, MP_SamBaseBoard_V1-F_Paste.gbr]
2020-06-04 Place old V1 to V0
    [MP_SamBaseBoard_V0.csv, MP_SamBaseBoard_V0.kicad_pcb, MP_SamBaseBoard_V0.sch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]
2020-06-04 migrate to V1
    [MP_SamBaseBoard_V1.kicad_pcb, MP_SamBaseBoard_V1.sch]
2020-06-06 Add missing components, edit foorprint
    [MP_SamBaseBoard_V1.kicad_pcb, MP_SamBaseBoard_V1.sch]
2020-06-11 finalize 1
    [MP_SamBaseBoard_V1.kicad_pcb, MP_SamBaseBoard_V1.sch]
2020-06-22 Adding OLED display in progress
    [MP_SamBaseBoard_V1.sch]
2020-06-22 Update OLED display, not complete
    [MP_SamBaseBoard_V1.kicad_pcb, MP_SamBaseBoard_V1.sch]
2020-06-23 Finalize OLED footprint placement
    [MP_SamBaseBoard_V1.kicad_pcb]
2020-06-27 Making files
    [MP_SamBaseBoard_V1-B.Cu.gbr, MP_SamBaseBoard_V1-B.Mask.gbr, MP_SamBaseBoard_V1-B.Paste.gbr, MP_SamBaseBoard_V1-B.SilkS.gbr, MP_SamBaseBoard_V1-Edge.Cuts.gbr, MP_SamBaseBoard_V1-F.Cu.gbr, MP_SamBaseBoard_V1-F.Mask.gbr, MP_SamBaseBoard_V1-F.Paste.gbr]
2020-06-27 1st PCB assy commit
    [MP_SamBaseBoard_V1.0.csv, MP_SamBaseBoard_V1.csv]
2020-06-28 Update fab files
    [MP_SamBaseBoard_V1.0-SEEED.csv]
2020-06-29 update assy file
    [MP_SamBaseBoard_V1.0-PCBWAY.csv]
2020-07-10 Update design
    [MP_SamBaseBoard_V1.sch]
2020-07-10 Update new design
    [MP_SamBaseBoard_V1.kicad_pcb]
2020-07-10 Last update
    [MP_SamBaseBoard_V1.0-PCBWAY.csv]
2021-03-02 v4 upgraded, Improved 5V track location, ground pouring and some via holes position.
    [MakerPlayground_Baseboard.kicad_pcb]
